hckwhr/fpga-instrument/docs/submission/figures/recording.pdf

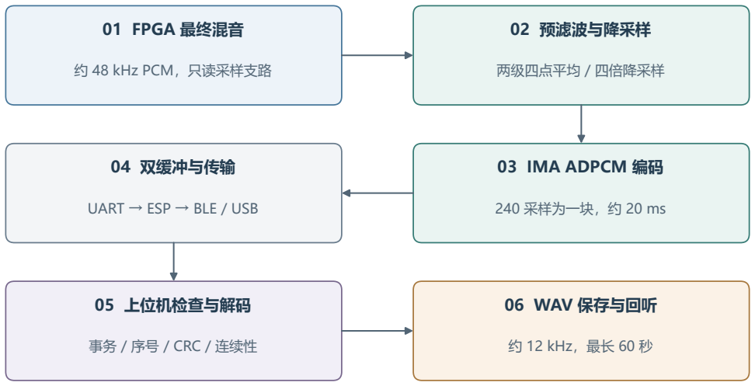
[picture p2: figure]
01 FPGA 最终混音; 约 48 kHz PCM，只读采样支路; 02 预滤波与降采样; 两级四点平均 / 四倍降采样; 03 IMA ADPCM 编码; 240 采样为一块，约 20 ms; 04 双缓冲与传输; UART → ESP → BLE / USB; 05 上位机检查与解码; 事务 / 序号 / CRC / 连续性; 06 WAV 保存与回听; 约 12 kHz，最长 60 秒

回传来自实际数字混音，不包含 DAC 与扬声器的模拟特性。
