hckwhr/fpga-instrument/docs/submission/figures/upload.pdf

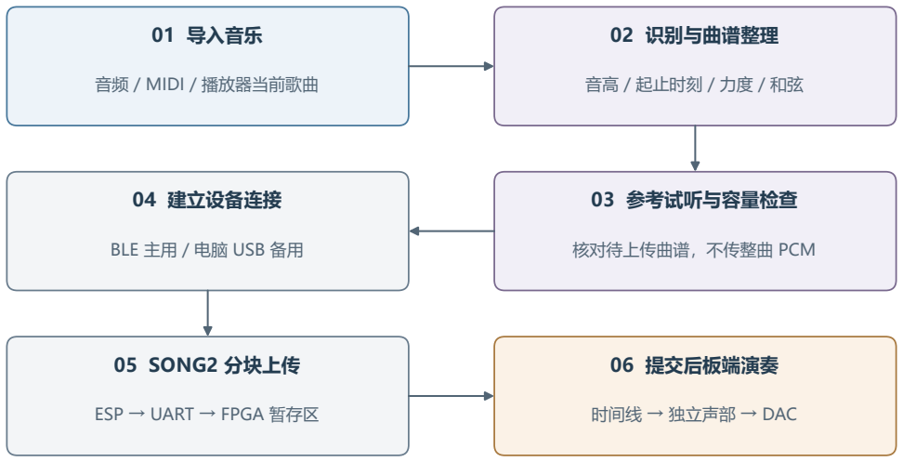
[picture p3: figure]
01 导入音乐; 音频 / MIDI / 播放器当前歌曲; 02 识别与曲谱整理; 音高 / 起止时刻 / 力度 / 和弦; 03 参考试听与容量检查; 核对待上传曲谱，不传整曲 PCM; 04 建立设备连接; BLE 主用 / 电脑 USB 备用; 05 SONG2 分块上传; ESP → UART → FPGA 暂存区; 06 提交后板端演奏; 时间线 → 独立声部 → DAC

COMMIT 发布完整曲谱；PLAY 才启动演奏时间线。
