hckwhr/fpga-instrument/docs/portfolio/README.md

# 灵弦：项目展示与求职材料

推荐项目名：**灵弦——基于 FPGA 的实时多音色合成与交互演奏系统**。

这个项目适合作为 FPGA / 数字 IC 前端 / 嵌入式系统岗位的主要项目。最值得讲清的是：独立声部如何调度、异步通信如何落到确定的板端动作、优化后如何证明功能和时序。上位机和 Android 应用体现系统完整度，投递 FPGA 岗位时不必占据简历的大部分篇幅。

| 材料 | 用法 |
| --- | --- |
| [简历条目](RESUME.md) | FPGA 岗位版、嵌入式岗位版、短版项目介绍 |
| [面试讲解](INTERVIEW.md) | 90 秒介绍、三个技术案例、追问与代码入口 |
| [演示与证据](EVIDENCE.md) | 三分钟展示顺序、数字来源与当前版本边界 |
| [仓库首页](../../README.md) | 发给招聘方的公开项目入口 |

GitHub：https://github.com/hckwhr/fpga-instrument

材料按 2026-11-11 归档状态整理。本次仅更新仓库展示和文档，不改变已验收 RTL、固件、应用逻辑或板上程序。

## 写进个人简历之前

材料描述的是项目已有成果。团队的硬件、软件和联调分工需要按本人实际参与情况填写；不要把整个团队、开源播放器或云端语音模型的工作写成个人独立开发。简历上保留自己能从接口、状态机、波形和测试讲清楚的内容；参与整合和验证也可以直接写“负责集成与验证”。

项目经历不依赖获奖标签。没有获得的奖项、名次和线下资格不写入；以源码、实物演奏、仿真与实施报告说明完成度。最新版本的 STA 通过与历史版本上板成功分别表述。
