hckwhr/fpga-instrument/hardware/V5/README.md

# V5 键盘板硬件工程

[键盘按键V5.epro2](键盘按键V5.epro2) 是当前 V5 键盘板的嘉立创 EDA 工程文件，由作者于 2026-11-01 提供。

使用嘉立创 EDA 专业版导入该文件，查看和编辑硬件设计。工程包含设计数据及内嵌图片资源，按原文件保存，不拆分内部数据。

对应 FPGA 源码入口为 [v3_hdmi_top.gprj](../../fpga/playability/v3_hdmi_top.gprj)，系统连接说明见 [HARDWARE.md](../../docs/HARDWARE.md)。
