hckwhr/fpga-instrument/fpga/rhythm/DECIMAL_CHANGE.md

# HDMI 单屏数字预计算

基线为 `v5_rhythm_hdmi_20261108`。该候选在 place3/route2 下报告 35 条未布通，
没有 `.pr`、时序报告或位流。原目录和失败报告保留。

失败日志没有网络名称，因此本次不能宣称十进制显示是那 35 条网络的已证实根因。
组合 BCD 中间实验未节省资源，未送 P&R。本候选改为帧前串行预计算：六字段共用
一个 BCD 加三单元。F 提交状态快照，F+1 读新状态，F+78 前完成全部字段转换。
生产 DMT 扫描在 60 行后显示画布，即 61440 拍，余量大于 787 倍。

- 数字在帧前预计算，RGB/HS/VS/DE 像素延迟不变，仍读取同一帧快照并输出相同字形。
- 保留短布局中 `position/100` 传入四位形参的截断行为，包括异常越界组合。
- 坐标除法、音频、32 声部、8 物理弦、菜单、RGB、UART、HDMI PHY 不改。
- 原 162 项全部保留；新增一项穷举，覆盖 4096 个值、全部长度及 999/1000 边界，
  并对优化前冻结渲染器进行 245760 次字形比较，总计 163 项。另检查 78 拍期限、
  提前使用必须发散的负向控制、中途换帧以及复位恢复。
- 先通过仿真和综合对照，再决定是否进入相同 place3/route2 的 P&R。
- 新网表重新生成共同 CE 约束并验证压缩等价，不沿用旧网表的端点名单。
- 本轮不烧录、不推送 GitHub。实测结果另记于 artifacts。
