hckwhr/fpga-instrument/fpga/rhythm/HDMI_ONLY_CHANGE.md

# HDMI 单屏恢复边界

- 基于已烧录双屏源码，独立目录开发，不覆盖双屏构建或板上程序。
- 生产顶层默认关闭双屏参数，去掉 LCD 物理端口。原 HDMI 菜单状态不再被屏蔽，
  原仪表盘负责设置与演奏两个页面。
- LCD PLL、LCD 时序、LCD 设置渲染与双屏专用演奏渲染不进入生产文件列表。
  相关源文件仅供历史模块回归，不删除旧功能验证证据。
- 删除 LCD 的 23 个物理输出约束及独立生成时钟，预期回到 31 I/O、4 时钟。
  端点压缩写法和共同 CE 连接图证明保持不变，新 SDC 必须来自新综合网表。
- 不修改音频引擎、PT8211 帧率、节奏事件、ADC/RGB 映射、串口协议或 HDMI PHY。
- 新增实体菜单刷新检查，原 161 项回归全部保留，总计 162 项；另运行三项官方 PHY。
- 用户所述显示迟滞尚未完成硬件根因归因，本候选不声称 LCD CDC 已被证明有误；
  按用户选择取消第二显示链路，并验证恢复后的 HDMI 页面每次按键都能更新。
- 本轮不自动烧录、不推送 GitHub。
