hckwhr/fpga-instrument/fpga/rhythm/DUAL_DISPLAY_CHANGE.md

# LCD 设置与 HDMI 演奏候选

目标板为 Tang Mega 138K，SOM30354 / Dock31005，GW5AST-138C，搭配 V5 压力键。
工程继承已烧录的 `v5_rhythm_timing_20261107`，保留其压力流水线、音频采样、
32 声部、8 路物理弦与串口协议。当前候选不能用基线的时序报告代替验收。

## 显示分工

- 原 800×480 RGB LCD：复用已验证的 33.333 MHz PLL、1057×526 总时序和
  23 个 LCD 引脚。独立的稳定总线握手传递设置快照，按 LCD 帧边界提交。
  设置快照不复用演奏快照中被曲目进度、按键状态占用的字段。
- HDMI：保留当前实物已支持的 800×600 DMT 输出及中心 800×480 画布。
  纯白背景，12 个固定键位，蓝色频谱、紫色李萨如，波形前景色保持原样。
  不显示参数文本，进入设置仍显示音频可视化。琴键按物理索引显示，
  跟练自定义音高不会改变左右位置。
- 两屏独立光栅和帧提交，不互相等待，不回压音频。新增 LCD 时钟及引脚
  需以本候选的实现报告验证；目标为 54 个物理 I/O、5 个时钟。

## 跟练所有权

普通 STOP 的历史语义保留。PERF1 操作 6 的启用命令先用共同 CE 交接
曲目/试听所有权，再在下一 CE 检查接收条件，后续 CE 快照并应答。
上位机仍先 STOP 再开始练习。CRC 无效、保留位非零和按键忙不触发交接；
菜单与本地操作优先级不被绕过。丢连接仍由原租约保护，不自动退回自由发声。

## 验证入口

`sync_test.ps1` 同步到独立 ASCII E 盘目录并运行专项；`-Full` 同步全部
候选输入并执行 161 项回归（原 159 项保留，新增双屏模块与双屏整机各 1 项）。
已有节奏整机用例增加内置曲、实际 SONG2 上传播放停止后切入跟练。
`verify_phy.ps1` 运行 3 项官方器件模型测试。

先综合，再对实际新网表运行 `prepare_constraints.ps1`，证明共同 CE、压缩
集合等价及负向控制，再用 place3/route2 实现。新增 LCD CDC 仅其音频侧可
进入 CE 证明，LCD 捕获侧保持全速；不按名字跳过证明。
通过建立/保持/恢复/移除检查、setup ≥ +0.03 ns、hold ≥ 0 和实际引脚审计后
才可作为烧录候选。当前任务不自动烧录，不推送 GitHub。

`TIMING_CHANGE.md` 是继承基线的压力流水线变更说明，不是本候选验收结果。
