hckwhr/fpga-instrument/fpga/rhythm/RHYTHM_PROTOCOL.md

# 实体 12 键跟练协议

目标：Tang Mega 138K，GW5AST-138C，SOM30354 / Dock31005 + V5 压力键。本双屏候选继承已验收 `v5_rhythm_timing_20261107`，保持原音频时钟、采样和既有音色，另恢复 LCD 的独立时钟与 23 个引脚。改动前证据为已烧录基线；本候选验收见 artifacts 对应报告，不能引用旧报告代替。

复用 PERF1 固定长度、CRC16-CCITT、8 位十六进制请求 ID、串口路由及 sys/audio 双向稳定总线握手。ESP 只转发完整文本行，不解析操作码。

请求 `PERF1,ID,OP,PAYLOAD,CRC\n`，41 字节；应答 `PERF1,ID,A,OP,STATUS,PAYLOAD,CRC\n`，45 字节。操作 0—5 保留原契约。6 写入提示或停止，7 查询并续租；7 请求负载必须为零。

操作 6 的 72 位负载：11:0 为左至右 12 键目标掩码；43:12 为 32 位提示编号；44 为启用；71:45 保留零。停止必须为全零。成功状态码 0，忙 2，无效 3。重复相同提示编号及掩码只续租、不清命中；相同编号不同掩码拒绝。主机一轮会话中递增编号，不重用旧编号作为新提示。

6/7 成功应答：71:70 标记 2，69 保护状态，68 活跃状态，67:36 提示编号，35:24 实体按键，23:12 本提示累计命中，11:0 剩余指引。主机同时验证请求 ID、操作码、CRC、提示编号与目标掩码；必须写入完成且应答到达才认定命令完成。失败应答不解释状态负载。

音频域在共同 CE 上接受命令。操作 6 的启用请求先核对保留位及按键占用状态：第一个 CE 交接曲目/试听所有权，第二个 CE 在更新后的阻塞条件下提交 gate，第三个 CE 将状态快照到原 result_map，随后返回 ACK。设置、本地停止和远程播放的优先级不被绕过；CRC 无效、保留位非零或按键忙不触发交接。其他节奏请求仍由 gate 更新后在下一 CE 快照。请求载荷保持到应答返回；结果快照保持到下次命令。没有新增异步多位直接采样。映射查询/修改与节奏命令串行，录音占有期间禁止节奏操作；节奏保护期间拒绝录音开始和键位修改。

实体新按下沿与目标掩码交集才加入播放键；旧按住键不能命中新提示。累计命中直到下一提示，因而按下和松开均早于轮询也不丢音。已接受的键保持到实体释放，不依赖 BLE 往返触发或关闭。原键盘事件 ID、32 声部与 8 路物理弦所有权逻辑不变。

租约 75,000,000 个 CE，生产约 3.05 秒。收到有效查询或提示续租。失联、设置、曲目抢占导致活跃清零，保留保护并清播放键，不能回退成无条件演奏；已有包络自然释放。明确停止解除保护，并抑制停止时仍按住的实体键直到释放。正常结束还恢复开始前的自定义映射或默认键阶；恢复失败必须上位机提示。

验证包含 gate 的 CE/租约/重奏/错按/和弦/停止，UART CRC、跨域请求应答、录音与映射互斥；整机串口及 ADC 引脚刺激、实际 C17 GRB 解码及 PT8211 PCM 解码，分别覆盖物理弦与 32 声部路径。本次补充内置曲目、实际 SONG2 上传播放停止后切入跟练，以及非法请求不交接所有权的检查。继承基线 159 项全部保留，新增双屏模块和双屏整机各 1 项，共 161 项；运行结果以本候选日志为准。
