hckwhr/fpga-instrument/host/instrument-web/RHYTHM_MODE.md

# 节奏大师（上位机练习模式）

FPGAvedio 有三个入口：播放器、FPGA 播放、节奏大师。桌面通过顶部按钮切换，手机通过左侧功能菜单切换。三个模式共用同一个曲谱工作台和连接会话，切换不会重新创建 BLE 连接。

## 使用

1. 打开节奏大师，选择《小星星》《欢乐颂》、FPGA 工作台当前曲谱或本地曲谱库。
2. 选择跟练或挑战，点击开始练习。两秒准备后，音符沿轨道落到判定线。
3. 电脑使用 `A S D F G H J K L ; ' Enter`；手机触摸音名对应的琴键。只在按对时合成声音，等待、漏按或错按不播放曲谱音频。
4. 跟练会在当前起音处等待，和弦的所有音都命中才继续。挑战保持时间推进，按起音偏差记录 Perfect（±70 ms）、Good（±160 ms）和 Miss。
5. 同一个键需松开后重新按下，长按及操作系统键盘连发不会重复计分。支持同时按多个键；部分电脑键盘存在硬件键位冲突，不能将其视为乐器压力键故障。
6. 暂停、切换模式、窗口失焦或进入后台会暂停练习并释放声音。返回后需主动继续，不自动恢复播放器音乐。

开始、暂停和重来在琴键画面上方。修改曲谱、速度或练习方式会重开本次练习。完成后显示命中数、最高连击、错按数和完成分。当前只对起音计分，长音提前松开会停止声音，不评价保持时长。

## 使用自己的曲谱

在 FPGA 播放中导入音频或 MIDI，完成转谱/音轨选择后，点击“用当前曲谱练习”。也可保存到曲谱库后在节奏大师中选择。曲谱库保存的是源音符，载入时只应用一次原有速度与力度设置，练习速度是其上的独立倍率。

固定 12 个键位，编号 01—12 对应左到右的位置，换曲不再重新排列。可选择 C 大调白键（C4、D4、E4、F4、G4、A4、B4、C5、D5、E5、F5、G5）或半音阶（C4—B4）。曲谱包含键阶之外的音高时明确拒绝；不自动删音、移调或折叠八度。同刻同音的多轨音符合并为一次按键，保留较长时值和较强力度，并显示合并数量。本机模式不改板端键位；实体模式临时配置所选键阶，停止且松开压力键后恢复原设置。

舞台使用近宽远窄的透视轨道，音符、长音尾迹和节拍线共用投影。宽屏左侧显示得分和连击，右侧保留曲谱与练习设置；手机竖屏的触键分成两排，以编号对应上方 12 条轨道。继续沿用播放器背景、字体及三模式切换。

## 硬件边界

“演奏设备”选择 **FPGA 实体 12 键 · RGB 跟练**。先在 FPGA 工作台连接 BLE 或 USB，退出板端设置并松开全部压力键，再开始。上位机先停止板端自动播放，读取原键位，再配置练习键阶。必须收到 FPGA 确认才进入跟练。旧位流不会被当作支持联动，需使用配套节奏协议位流。

到达当前音符时，RGB 以青色提示对应压力键。FPGA 在本地判断新按键是否属于本组目标，按对后直接进入原有声部/物理弦通路；按错不触发新音。力度和音色仍来自板端设置，声音不由电脑代播。和弦可以同时或依次按齐；同音下一次起音必须先松开。起音命中持续保存在本组状态，快速按下又松开也不会因蓝牙轮询漏掉。

实体模式只提供跟练，不把 BLE 收包时刻当作演奏时刻进行 Perfect/Good 评分。暂停、切换、失焦会发送停止；通信丢失时，板端约 3 秒租约到期后撤销提示与按键保持，阻止继续触发。已有音符按原包络释放，效果器尾音不会被硬切。恢复需要明确停止再开始，旧提示不会自动重播。停止后请松开压力键，让原键位恢复；无法确认恢复时界面会提示，不宣称已恢复。

这里演奏的是已转换的音符曲谱，不是直接把 MP3 音频流送到 FPGA。选择“FPGA 工作台当前曲谱”即可使用当前整理后的音乐；固定 12 键之外的音高仍需先在工作台明确处理。

## 维护与验证

- `src/rhythm-engine.js`：可独立测试的曲谱校验、时间推进、按键判定和计分。
- `src/rhythm-audio.js`：只由命中事件启动的本机合成音，松键/暂停释放。
- `src/rhythm-session.js`：实体会话、CRC 应答、提示序号、独占链路、轮询和停止恢复。
- `src/rhythm-view.js` / `src/rhythm.css`：共享桌面/手机界面、曲谱来源及生命周期。
- `npm run build`：语法检查、原有测试及新增节奏测试、离线资源构建。
- Mineradio 的 `tools/desktop-smoke.mjs`：实际打包应用中的模式切换、静音直到命中、松键重奏、原工作台回归。
- `tools/app-smoke.mjs --player`：手机尺寸浏览器中的菜单入口、触摸命中与原有转谱上传回归；其 BLE/板端应答是模拟数据，不代表手机或 FPGA 实物验收。

本机练习不依赖新位流。实体跟练需要更新 FPGA 和上位机；现有 ESP 完整行透明桥可转发新命令，不需要仅为这项功能重新烧录 ESP。Android 页面共用实现，APK 安装是单独的交付步骤。软件模拟接收端测试与 FPGA 引脚仿真均不代替实物联调。
