hckwhr/fpga-instrument/docs/submission/figures/design.pdf

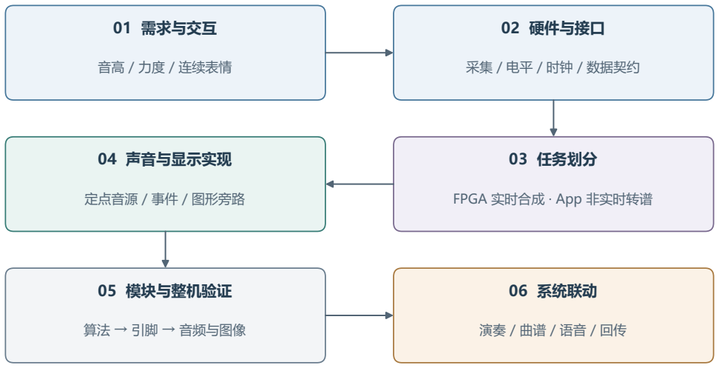
[picture p26: figure]
01 需求与交互; 音高 / 力度 / 连续表情; 02 硬件与接口; 采集 / 电平 / 时钟 / 数据契约; 03 任务划分; FPGA 实时合成 · App 非实时转谱; 04 声音与显示实现; 定点音源 / 事件 / 图形旁路; 05 模块与整机验证; 算法 → 引脚 → 音频与图像; 06 系统联动

先确定接口与采样期限，再核对完整输入输出链路。
