hckwhr/fpga-instrument/docs/submission/figures/display.pdf

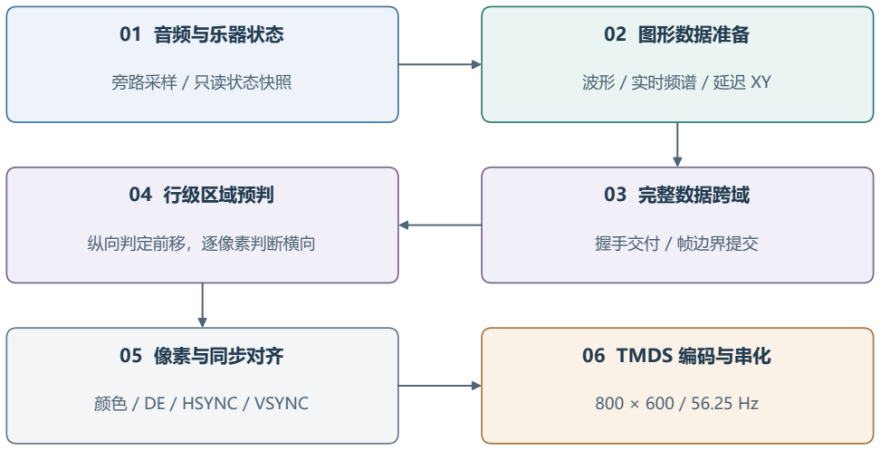
[picture p27: figure]
01 音频与乐器状态; 旁路采样 / 只读状态快照; 02 图形数据准备; 波形 / 实时频谱 / 延迟 XY; 03 完整数据跨域; 握手交付 / 帧边界提交; 04 行级区域预判; 纵向判定前移，逐像素判断横向; 05 像素与同步对齐; 颜色 / DE / HSYNC / VSYNC; 06 TMDS 编码与串化

显示和分析不反压音频；HDMI 仅输出图像。
