hckwhr/fpga-instrument/docs/submission/figures/events.pdf

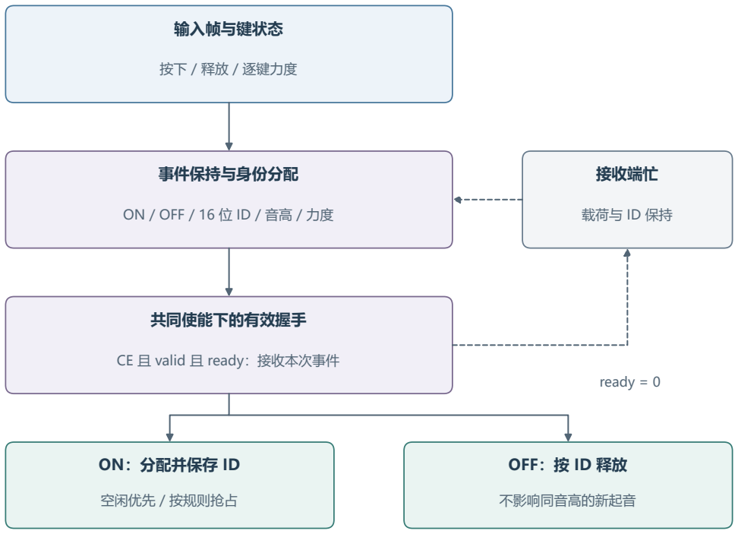
[picture p28: figure]
输入帧与键状态; 按下 / 释放 / 逐键力度; 事件保持与身份分配; ON / OFF / 16 位 ID / 音高 / 力度; 共同使能下的有效握手; CE 且 valid 且 ready：接收本次事件; 接收端忙; 载荷与 ID 保持; ON：分配并保存 ID; 空闲优先 / 按规则抢占; OFF：按 ID 释放; 不影响同音高的新起音; ready = 0
