hckwhr/fpga-instrument/docs/submission/figures/string.pdf

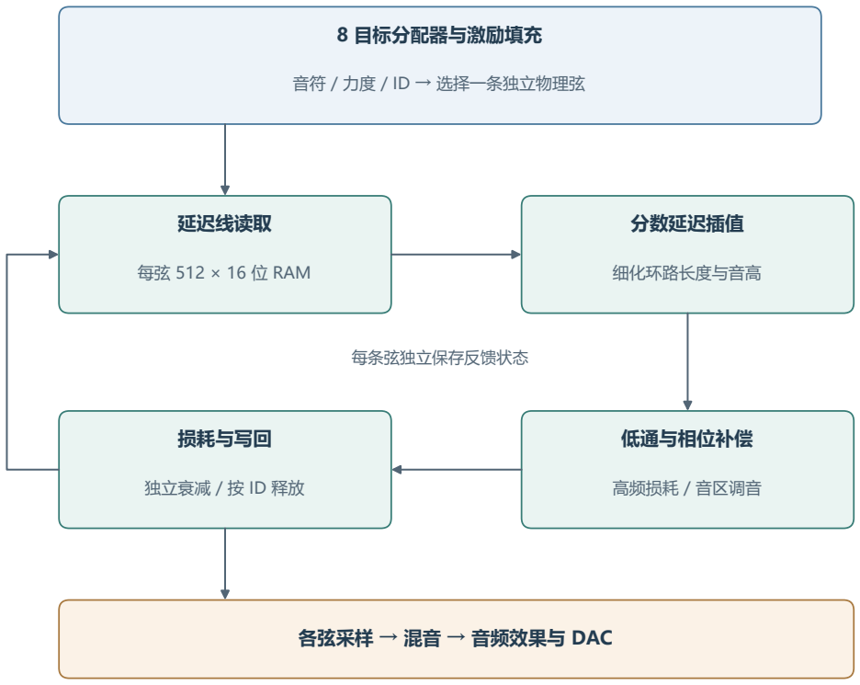
[picture p29: figure]
8 目标分配器与激励填充; 音符 / 力度 / ID → 选择一条独立物理弦; 延迟线读取; 每弦 512 × 16 位 RAM; 分数延迟插值; 细化环路长度与音高; 低通与相位补偿; 高频损耗 / 音区调音; 损耗与写回; 独立衰减 / 按 ID 释放; 每条弦独立保存反馈状态; 各弦采样 → 混音 → 音频效果与 DAC
