hckwhr/fpga-instrument/docs/submission/figures/voice.pdf

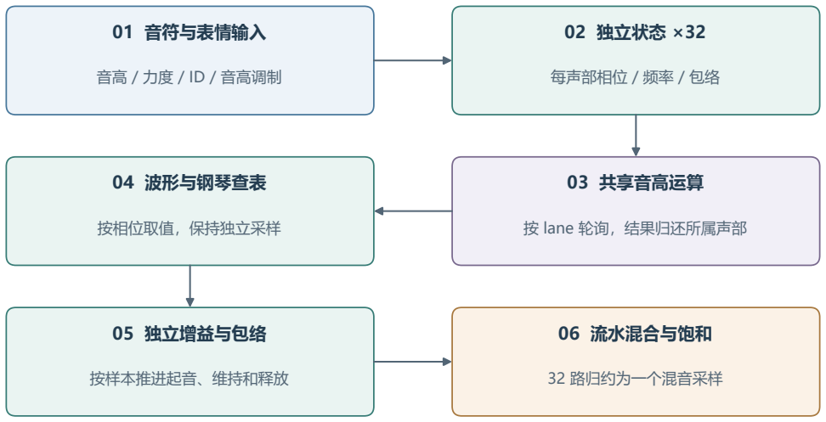
[picture p30: figure]
01 音符与表情输入; 音高 / 力度 / ID / 音高调制; 02 独立状态 ×32; 每声部相位 / 频率 / 包络; 03 共享音高运算; 按 lane 轮询，结果归还所属声部; 04 波形与钢琴查表; 按相位取值，保持独立采样; 05 独立增益与包络; 按样本推进起音、维持和释放; 06 流水混合与饱和; 32 路归约为一个混音采样

共享的是计算单元，32 份声部状态始终独立保存。
