hckwhr/fpga-instrument/docs/RHYTHM_MODE_VALIDATION.md

# 上位机节奏大师验证记录

日期：2026-11-05。

本次新增第三模式，保留播放器与 FPGA 工作台。FPGA RTL、ESP 固件和板端协议未修改。

| 验证 | 结果 |
| --- | --- |
| 共用上位机语法检查及构建 | 通过 |
| Node 单元测试 | 154 项通过，0 失败；原有 137 项，新增 17 项 |
| Windows 桌面包 | 构建通过 |
| Android 安装包 | 1.2.0（versionCode 106）构建通过，APK v2/v3 签名验证通过；未安装到手机 |
| 实际 Electron 桌面程序冒烟 | 通过；三模式往返、窗口控制、同一个工作台保持、未按静音、按对发声、重复键释放、暂停恢复、当前曲谱进入练习 |
| 原有工作台流程 | 通过；本地音频导入、真实模型转谱、整理、试听与可视化、模式切换后的曲谱保留 |
| 手机尺寸浏览器 | 390×844，侧栏进入、实际触摸事件命中、离开暂停、无横向溢出；通过 |
| 原手机上传与录音协议回归 | 通过；BLE/FPGA 应答使用明确标记的模拟端，不是实物验收 |

引擎测试覆盖：跟练等待、和弦、提前按下、按住不连击、松开重奏、Perfect/Good 实际毫秒窗口、漏按静音、暂停时间排除、重置、整曲结束、无效/超过 12 音高的曲谱拒绝、同刻同音合并及单调时钟要求。

运行中发现画面帧时间戳可能早于同帧输入时间戳，已统一采用 `performance.now()`；最终桌面与手机页面测试均通过。练习不发送自动播放或自定义硬件指令。

硬件限制：这一轮声音来自电脑/手机；实体 RGB 提示、压力键输入和 FPGA 本地判定仍需配套固件扩展。手机尺寸测试不等于已安装新版 APK。本轮未烧录 FPGA 或 ESP。

复现入口：`host/instrument-web` 中运行 `npm run build`；`host/mineradio` 中运行 `npm run prepare:fpga`、`npm run build:fpga:dir`、`node tools/desktop-smoke.mjs` 和 `node tools/app-smoke.mjs --player`。实际工具链路径见已有构建说明。
