hckwhr/fpga-instrument/fpga/rhythm/VALIDATION.md

# HDMI 单屏版本验收记录

2026-11-10：设置页和演奏页均恢复到底板 HDMI；LCD 不再参与生产工程。
完整回归、官方器件模型、P&R、时序及引脚/时钟审计通过，位流已生成，尚未烧录。
当前板上程序保持原样，未推送 GitHub。

## 行为与验证

- 实体设置键在 HDMI 打开设置页，退出后恢复原浅色仪表盘及演奏可视化。
- 保留音色切换、32 独立声部、8 路物理弦、12 压力键、RGB 与节奏跟练修复。
- 顶层去掉 23 个 LCD 物理输出及独立 LCD 时钟，生产文件列表不含 LCD 显示链。
  历史双屏源文件和用例保留，仅用于模块回归。
- 曲目进度、长度、速度、弦统计、力度、声部数共用帧前十进制预计算。
  帧后 78 拍完成，画布在 61440 拍后出现；像素/同步流水及画面内容不变。
  新增路径按正常像素时钟检查，没有增加时序放宽。

| 检查 | 证据 |
| --- | --- |
| 完整 RTL 回归 | 163 通过 / 0 失败；原 161 项保留，新增菜单刷新和数字预计算各 1 项 |
| 官方 HDMI 模型 | PLL 启动/频率、串化顺序、停钟复位 3 项通过 |
| 菜单引脚 | 十次单独按键音色切换，两帧内刷新，帧内不撕裂；退出后压力键到 DAC 解码通过 |
| 数字与帧边界 | 4096 个位置/长度及全部其他字段取值；245760 次冻结字形对照；63616 个曲目区像素对照 |
| 期限与异常控制 | 78 拍期限；提前使用负向用例确实发散；换帧中断、复位恢复、同拍状态更新通过 |
| 仪表盘等价 | 4608000 个缩放像素一致，含主界面与两页菜单及非恒定波形 |
| 演奏与跟练 | 实体 UART/ADC 激励到 RGB/PT8211 解码；错键静音、和弦、释放重按、歌曲 STOP 后切换跟练通过 |
| 共同使能 | 新网表 15992 个半速 FF、29 个模块；32 相位、32 包络和 8 路物理弦保留 |
| 约束压缩 | 捕获端查询 1800→633，20 个对象集合一致；6 项压缩控制和 4 项层级/使能控制通过 |
| 生效约束 | 4 个时钟、10 条 multicycle 命令；4 对共同 CE、1 对串化停钟复位 |
| 引脚 | 31 个物理 I/O 全覆盖，器件、差分配对、I/O 类型、电压、驱动和上下拉一致 |

## 实施结果

Gowin V1.9.12.03，GW5AST-LV138PG484AC1/I0，SOM30354 + Dock31005。
place3/route2 已从 `cmd.do` 核实，P&R 回执耗时 898.463 秒（约 15 分钟）。
工具正常结束、零错误，新的 `.pr`、完整 STA、引脚报告、`.fs` 均已生成。
成功日志没有单列未布通总数，不把缺失计数字段填成实测的 0。

| 指标 | 最终 P&R 报告 |
| --- | --- |
| Logic | 72539 / 138240（53%） |
| LUT / ALU / ROM16 | 57226 / 15313 / 0 |
| Register | 34810 / 139095（26%），锁存器 0 |
| CLS | 48587 / 69120（工具显示 71%） |
| BSRAM / DSP | 205 / 340；126 / 298 |
| SSRAM | 0 |
| Setup / hold | +0.556 ns / +0.187 ns |
| 建立 / 保持违例端点 | 0 / 0 |
| Recovery / Removal 最差余量 | +8.387 ns / +0.253 ns |
| Recovery / Removal 报告负余量 | 0 / 0，均有完整分析及最差路径表 |

满足 setup ≥ +0.03 ns、hold ≥ 0 的项目门槛。日志有一条 PR1014：`sys_clk_d`
使用通用布线资源；最终约束分析通过，但不把此警告解释为硬件实测结论。
本版 setup 小于先前已验收双屏版的 +2.010 ns，不能宣称时序余量提升。

源文件和实际构建输入哈希一致；SDC 的 20 个对象集合已对本次网表逐一证明等价。
Gowin HTML 对多行命令仅展示首行，完整端点与边沿语义需结合下列 SDC 哈希及
集合等价审计，不能只凭 HTML 首行声称证明全部端点。

位流 SHA256：`ff40e3adb2035a7261988d1a0774d62428b2bd41358e26e88484d48e5b972549`。
SDC SHA256：`d44577825f3f794bbaef5d3864755a66f3f14b100b58fafd3b7b8de960586e7f`。
综合网表 SHA256：`f426a74d1bb4dc01467afa8e192f2251a6f2825e786253d0fa48342be484a3aa`。

综合 ID：`d06cf2f74d314aa59fb8a9f8b40067bd`。
P&R ID：`f347393e8aa7430b9257dc4b44fc0fc3`。
本机证据：`artifacts/v5_rhythm_hdmi_digits_20261110/`，含原报告、位流、测试日志、
`result.json`、`input_hashes.json`、`applied_constraints.json`。
本机源目录：`work/v5_rhythm_hdmi_digits_20261110`。

此前 35 条未布通报告及没有资源收益的组合 BCD 实验均单独保留。
仿真证明在模型条件下每次菜单切换能更新；实际显示器和按键体验需烧录后观察，
本报告不将用户此前的 LCD 迟滞归因为已经证明的某个硬件故障。
