hckwhr/fpga-instrument/docs/submission/assets/performance.png

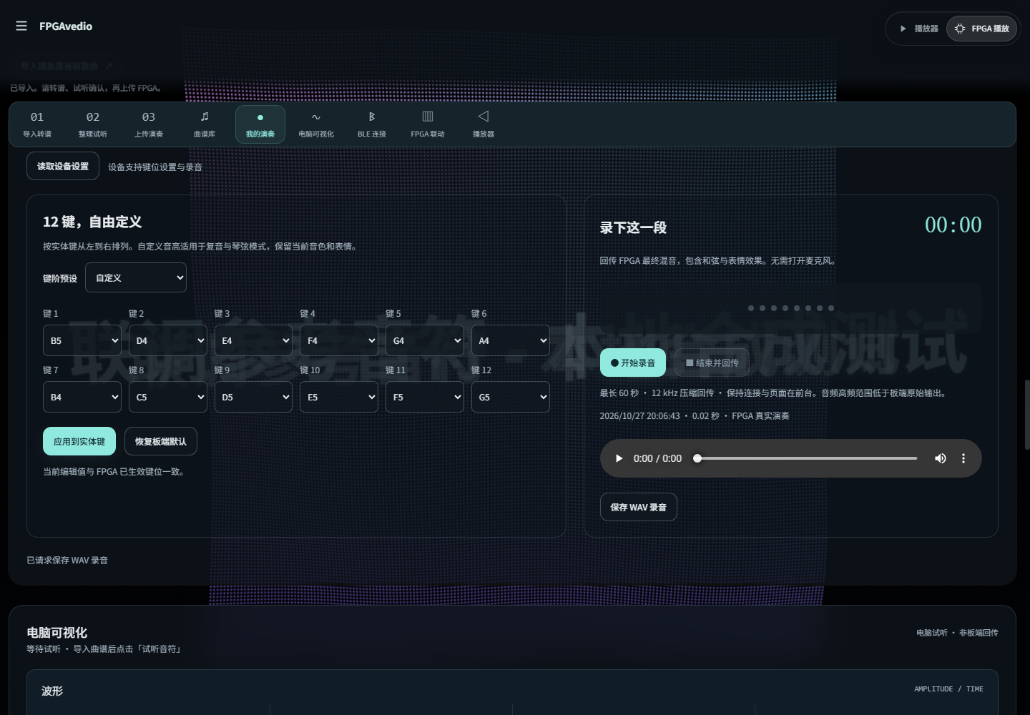
docs/submission/assets/performance.png
