hckwhr/fpga-instrument/docs/submission/figures/architecture.pdf

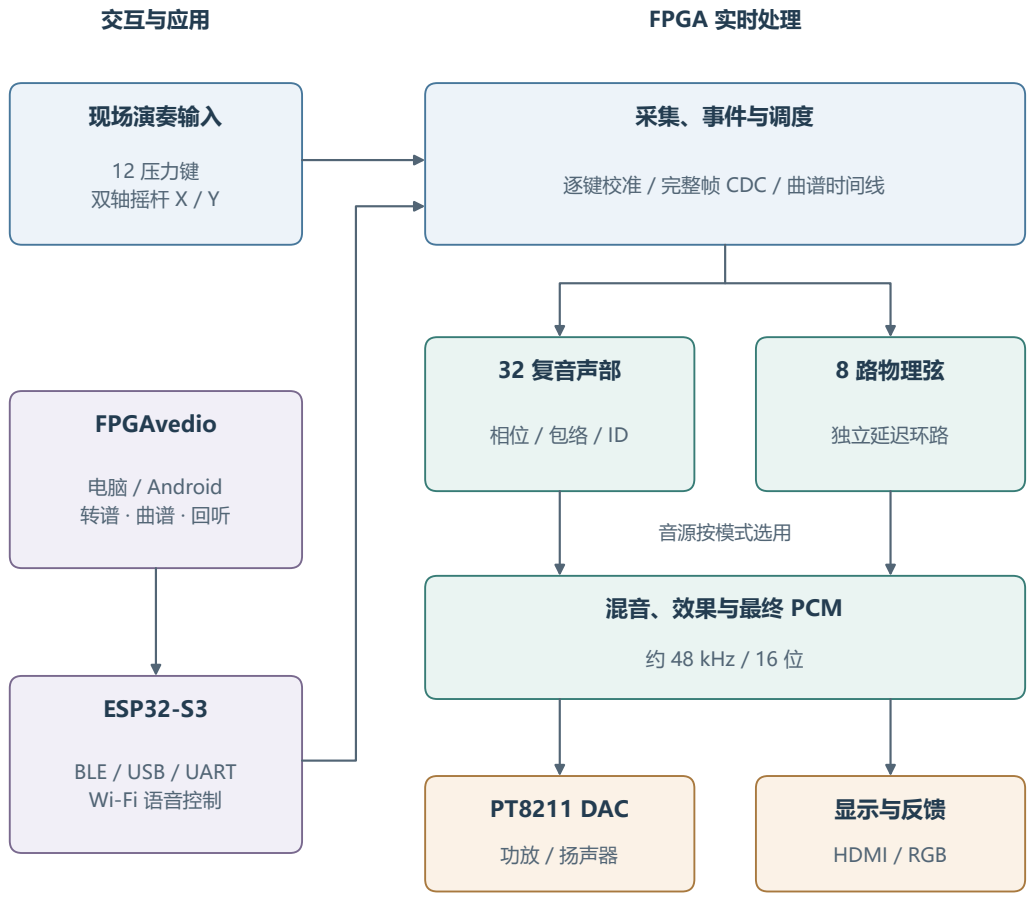
[picture p51: page 1]
交互与应用; FPGA 实时处理; 现场演奏输入; 12 压力键 双轴摇杆 X / Y; FPGAvedio; ESP32-S3; 采集、事件与调度; 32 复音声部; 8 路物理弦; 独立延迟环路; 约 48 kHz / 16 位; PT8211 DAC; 功放 / 扬声器; 显示与反馈; HDMI / RGB; 音源按模式选用

逐键校准 / 完整帧 CDC / 曲谱时间线

电脑 / Android

混音、效果与最终 PCM

BLE / USB / UART
Wi-Fi 语音控制
