hckwhr/fpga-instrument/firmware/xiaozhi-v3/main/boards/fpga-bread-s3/config.h

#pragma once
#include <driver/gpio.h>

// XiaoZhi v1.9.4 bread-compact-wifi SIMPLEX wiring, NOT the V3 PCB.
#define AUDIO_INPUT_SAMPLE_RATE 16000
#define AUDIO_OUTPUT_SAMPLE_RATE 24000
#define AUDIO_I2S_MIC_GPIO_WS GPIO_NUM_4
#define AUDIO_I2S_MIC_GPIO_SCK GPIO_NUM_5
#define AUDIO_I2S_MIC_GPIO_DIN GPIO_NUM_6
#define AUDIO_I2S_SPK_GPIO_DOUT GPIO_NUM_7
#define AUDIO_I2S_SPK_GPIO_BCLK GPIO_NUM_15
#define AUDIO_I2S_SPK_GPIO_LRCK GPIO_NUM_16
#define BOOT_BUTTON_GPIO GPIO_NUM_0
#define TOUCH_BUTTON_GPIO GPIO_NUM_47
#define VOLUME_UP_BUTTON_GPIO GPIO_NUM_40
#define VOLUME_DOWN_BUTTON_GPIO GPIO_NUM_39
#define BUILTIN_LED_GPIO GPIO_NUM_48
#define DISPLAY_SDA_PIN GPIO_NUM_41
#define DISPLAY_SCL_PIN GPIO_NUM_42
// GPIO17 TX -> FPGA A20; GPIO18 RX <- FPGA A21. No lamp on GPIO18.
// USB GPIO19/20, flash/PSRAM pins and the original audio pins are untouched.
