hckwhr/fpga-instrument/fpga/rhythm/rtl/fsr_instrument_top.v

`default_nettype none
// V2 board wrapper: the ADC owns A15; no UART or V3-header outputs are bonded.
module fsr_instrument_top (
    input wire sys_clk,key0_n,key1_n,key2_n,setting_key,adc_miso,
    output wire adc_sclk,adc_mosi,adc_cs0_n,adc_cs1_n,
    output wire [3:0] adc_led,
    output wire audio_bck,audio_ws,audio_din,audio_pa_en_n,
    output wire lcd_pclk,lcd_hsync,lcd_vsync,lcd_de,lcd_bl,
    output wire [5:0] lcd_r,lcd_g,lcd_b
);
    av_top #(.FSR_ENABLE(1)) u_instrument (
        .sys_clk(sys_clk),.key0_n(key0_n),.key1_n(key1_n),.key2_n(key2_n),.setting_key(setting_key),
        .hc05_rx(1'b1),.hc05_tx(),.status_led(),.ws2812_data(),.led_enable(),
        .adc_miso(adc_miso),.adc_sclk(adc_sclk),.adc_mosi(adc_mosi),
        .adc_cs0_n(adc_cs0_n),.adc_cs1_n(adc_cs1_n),.adc_led(adc_led),
        .audio_bck(audio_bck),.audio_ws(audio_ws),.audio_din(audio_din),.audio_pa_en_n(audio_pa_en_n),
        .lcd_pclk(lcd_pclk),.lcd_hsync(lcd_hsync),.lcd_vsync(lcd_vsync),.lcd_de(lcd_de),.lcd_bl(lcd_bl),
        .lcd_r(lcd_r),.lcd_g(lcd_g),.lcd_b(lcd_b));
endmodule
`default_nettype wire
