hckwhr/fpga-instrument/firmware/xiaozhi-v3/main/display/lcd_display.cc

#include "lcd_display.h"
#include "assets/lang_config.h"
#include "settings.h"

#include <vector>
#include <algorithm>
#include <font_awesome.h>
#include <esp_log.h>
#include <esp_err.h>
#include <esp_lvgl_port.h>
#include <esp_psram.h>
#include <cstring>

#include "board.h"

#define TAG "LcdDisplay"

// Color definitions for dark theme
#define DARK_BACKGROUND_COLOR       lv_color_hex(0x121212)     // Dark background
#define DARK_TEXT_COLOR             lv_color_white()           // White text
#define DARK_CHAT_BACKGROUND_COLOR  lv_color_hex(0x1E1E1E)     // Slightly lighter than background
#define DARK_USER_BUBBLE_COLOR      lv_color_hex(0x1A6C37)     // Dark green
#define DARK_ASSISTANT_BUBBLE_COLOR lv_color_hex(0x333333)     // Dark gray
#define DARK_SYSTEM_BUBBLE_COLOR    lv_color_hex(0x2A2A2A)     // Medium gray
#define DARK_SYSTEM_TEXT_COLOR      lv_color_hex(0xAAAAAA)     // Light gray text
#define DARK_BORDER_COLOR           lv_color_hex(0x333333)     // Dark gray border
#define DARK_LOW_BATTERY_COLOR      lv_color_hex(0xFF0000)     // Red for dark mode

// Color definitions for light theme
#define LIGHT_BACKGROUND_COLOR       lv_color_white()           // White background
#define LIGHT_TEXT_COLOR             lv_color_black()           // Black text
#define LIGHT_CHAT_BACKGROUND_COLOR  lv_color_hex(0xE0E0E0)     // Light gray background
#define LIGHT_USER_BUBBLE_COLOR      lv_color_hex(0x95EC69)     // WeChat green
#define LIGHT_ASSISTANT_BUBBLE_COLOR lv_color_white()           // White
#define LIGHT_SYSTEM_BUBBLE_COLOR    lv_color_hex(0xE0E0E0)     // Light gray
#define LIGHT_SYSTEM_TEXT_COLOR      lv_color_hex(0x666666)     // Dark gray text
#define LIGHT_BORDER_COLOR           lv_color_hex(0xE0E0E0)     // Light gray border
#define LIGHT_LOW_BATTERY_COLOR      lv_color_black()           // Black for light mode


// Define dark theme colors
const ThemeColors DARK_THEME = {
    .background = DARK_BACKGROUND_COLOR,
    .text = DARK_TEXT_COLOR,
    .chat_background = DARK_CHAT_BACKGROUND_COLOR,
    .user_bubble = DARK_USER_BUBBLE_COLOR,
    .assistant_bubble = DARK_ASSISTANT_BUBBLE_COLOR,
    .system_bubble = DARK_SYSTEM_BUBBLE_COLOR,
    .system_text = DARK_SYSTEM_TEXT_COLOR,
    .border = DARK_BORDER_COLOR,
    .low_battery = DARK_LOW_BATTERY_COLOR
};

// Define light theme colors
const ThemeColors LIGHT_THEME = {
    .background = LIGHT_BACKGROUND_COLOR,
    .text = LIGHT_TEXT_COLOR,
    .chat_background = LIGHT_CHAT_BACKGROUND_COLOR,
    .user_bubble = LIGHT_USER_BUBBLE_COLOR,
    .assistant_bubble = LIGHT_ASSISTANT_BUBBLE_COLOR,
    .system_bubble = LIGHT_SYSTEM_BUBBLE_COLOR,
    .system_text = LIGHT_SYSTEM_TEXT_COLOR,
    .border = LIGHT_BORDER_COLOR,
    .low_battery = LIGHT_LOW_BATTERY_COLOR
};


LV_FONT_DECLARE(font_awesome_30_4);

LcdDisplay::LcdDisplay(esp_lcd_panel_io_handle_t panel_io, esp_lcd_panel_handle_t panel, DisplayFonts fonts, int width, int height)
    : panel_io_(panel_io), panel_(panel), fonts_(fonts) {
    width_ = width;
    height_ = height;

    // Load theme from settings
    Settings settings("display", false);
    current_theme_name_ = settings.GetString("theme", "light");

    // Update the theme
    if (current_theme_name_ == "dark") {
        current_theme_ = DARK_THEME;
    } else if (current_theme_name_ == "light") {
        current_theme_ = LIGHT_THEME;
    }
}

SpiLcdDisplay::SpiLcdDisplay(esp_lcd_panel_io_handle_t panel_io, esp_lcd_panel_handle_t panel,
                           int width, int height, int offset_x, int offset_y, bool mirror_x, bool mirror_y, bool swap_xy,
                           DisplayFonts fonts)
    : LcdDisplay(panel_io, panel, fonts, width, height) {

    // draw white
    std::vector<uint16_t> buffer(width_, 0xFFFF);
    for (int y = 0; y < height_; y++) {
        esp_lcd_panel_draw_bitmap(panel_, 0, y, width_, y + 1, buffer.data());
    }

    // Set the display to on
    ESP_LOGI(TAG, "Turning display on");
    ESP_ERROR_CHECK(esp_lcd_panel_disp_on_off(panel_, true));

    ESP_LOGI(TAG, "Initialize LVGL library");
    lv_init();

#if CONFIG_SPIRAM
    // lv image cache, currently only PNG is supported
    size_t psram_size_mb = esp_psram_get_size() / 1024 / 1024;
    if (psram_size_mb >= 8) {
        lv_image_cache_resize(2 * 1024 * 1024, true);
        ESP_LOGI(TAG, "Use 2MB of PSRAM for image cache");
    } else if (psram_size_mb >= 2) {
        lv_image_cache_resize(512 * 1024, true);
        ESP_LOGI(TAG, "Use 512KB of PSRAM for image cache");
    }
#endif

    ESP_LOGI(TAG, "Initialize LVGL port");
    lvgl_port_cfg_t port_cfg = ESP_LVGL_PORT_INIT_CONFIG();
    port_cfg.task_priority = 1;
#if CONFIG_SOC_CPU_CORES_NUM > 1
    port_cfg.task_affinity = 1;
#endif
    lvgl_port_init(&port_cfg);

    ESP_LOGI(TAG, "Adding LCD display");
    const lvgl_port_display_cfg_t display_cfg = {
        .io_handle = panel_io_,
        .panel_handle = panel_,
        .control_handle = nullptr,
        .buffer_size = static_cast<uint32_t>(width_ * 20),
        .double_buffer = false,
        .trans_size = 0,
        .hres = static_cast<uint32_t>(width_),
        .vres = static_cast<uint32_t>(height_),
        .monochrome = false,
        .rotation = {
            .swap_xy = swap_xy,
            .mirror_x = mirror_x,
            .mirror_y = mirror_y,
        },
        .color_format = LV_COLOR_FORMAT_RGB565,
        .flags = {
            .buff_dma = 1,
            .buff_spiram = 0,
            .sw_rotate = 0,
            .swap_bytes = 1,
            .full_refresh = 0,
            .direct_mode = 0,
        },
    };

    display_ = lvgl_port_add_disp(&display_cfg);
    if (display_ == nullptr) {
        ESP_LOGE(TAG, "Failed to add display");
        return;
    }

    if (offset_x != 0 || offset_y != 0) {
        lv_display_set_offset(display_, offset_x, offset_y);
    }

    SetupUI();
}

// RGB LCD实现
RgbLcdDisplay::RgbLcdDisplay(esp_lcd_panel_io_handle_t panel_io, esp_lcd_panel_handle_t panel,
                           int width, int height, int offset_x, int offset_y,
                           bool mirror_x, bool mirror_y, bool swap_xy,
                           DisplayFonts fonts)
    : LcdDisplay(panel_io, panel, fonts, width, height) {

    // draw white
    std::vector<uint16_t> buffer(width_, 0xFFFF);
    for (int y = 0; y < height_; y++) {
        esp_lcd_panel_draw_bitmap(panel_, 0, y, width_, y + 1, buffer.data());
    }

    ESP_LOGI(TAG, "Initialize LVGL library");
    lv_init();

    ESP_LOGI(TAG, "Initialize LVGL port");
    lvgl_port_cfg_t port_cfg = ESP_LVGL_PORT_INIT_CONFIG();
    port_cfg.task_priority = 1;
#if CONFIG_SOC_CPU_CORES_NUM > 1
    port_cfg.task_affinity = 1;
#endif
    lvgl_port_init(&port_cfg);

    ESP_LOGI(TAG, "Adding LCD display");
    const lvgl_port_display_cfg_t display_cfg = {
        .io_handle = panel_io_,
        .panel_handle = panel_,
        .buffer_size = static_cast<uint32_t>(width_ * 20),
        .double_buffer = true,
        .hres = static_cast<uint32_t>(width_),
        .vres = static_cast<uint32_t>(height_),
        .rotation = {
            .swap_xy = swap_xy,
            .mirror_x = mirror_x,
            .mirror_y = mirror_y,
        },
        .flags = {
            .buff_dma = 1,
            .swap_bytes = 0,
            .full_refresh = 1,
            .direct_mode = 1,
        },
    };

    const lvgl_port_display_rgb_cfg_t rgb_cfg = {
        .flags = {
            .bb_mode = true,
            .avoid_tearing = true,
        }
    };
    
    display_ = lvgl_port_add_disp_rgb(&display_cfg, &rgb_cfg);
    if (display_ == nullptr) {
        ESP_LOGE(TAG, "Failed to add RGB display");
        return;
    }
    
    if (offset_x != 0 || offset_y != 0) {
        lv_display_set_offset(display_, offset_x, offset_y);
    }

    SetupUI();
}

MipiLcdDisplay::MipiLcdDisplay(esp_lcd_panel_io_handle_t panel_io, esp_lcd_panel_handle_t panel,
                            int width, int height,  int offset_x, int offset_y,
                            bool mirror_x, bool mirror_y, bool swap_xy,
                            DisplayFonts fonts)
    : LcdDisplay(panel_io, panel, fonts, width, height) {

    // Set the display to on
    ESP_LOGI(TAG, "Turning display on");
    ESP_ERROR_CHECK(esp_lcd_panel_disp_on_off(panel_, true));

    ESP_LOGI(TAG, "Initialize LVGL library");
    lv_init();

    ESP_LOGI(TAG, "Initialize LVGL port");
    lvgl_port_cfg_t port_cfg = ESP_LVGL_PORT_INIT_CONFIG();
    port_cfg.task_priority = 1;
#if CONFIG_SOC_CPU_CORES_NUM > 1
    port_cfg.task_affinity = 1;
#endif
    lvgl_port_init(&port_cfg);

    ESP_LOGI(TAG, "Adding LCD display");
    const lvgl_port_display_cfg_t disp_cfg = {
            .io_handle = panel_io,
            .panel_handle = panel,
            .control_handle = nullptr,
            .buffer_size = static_cast<uint32_t>(width_ * 50),
            .double_buffer = false,
            .hres = static_cast<uint32_t>(width_),
            .vres = static_cast<uint32_t>(height_),
            .monochrome = false,
            /* Rotation values must be same as used in esp_lcd for initial settings of the screen */
            .rotation = {
            .swap_xy = swap_xy,
            .mirror_x = mirror_x,
            .mirror_y = mirror_y,
        },
        .flags = {
            .buff_dma = true,
            .buff_spiram =false,
            .sw_rotate = false,
        },
    };

    const lvgl_port_display_dsi_cfg_t dpi_cfg = {
        .flags = {
            .avoid_tearing = false,
        }
    };
    display_ = lvgl_port_add_disp_dsi(&disp_cfg, &dpi_cfg);
    if (display_ == nullptr) {
        ESP_LOGE(TAG, "Failed to add display");
        return;
    }

    if (offset_x != 0 || offset_y != 0) {
        lv_display_set_offset(display_, offset_x, offset_y);
    }

    SetupUI();
}

LcdDisplay::~LcdDisplay() {
    // 然后再清理 LVGL 对象
    if (content_ != nullptr) {
        lv_obj_del(content_);
    }
    if (status_bar_ != nullptr) {
        lv_obj_del(status_bar_);
    }
    if (side_bar_ != nullptr) {
        lv_obj_del(side_bar_);
    }
    if (container_ != nullptr) {
        lv_obj_del(container_);
    }
    if (display_ != nullptr) {
        lv_display_delete(display_);
    }

    if (panel_ != nullptr) {
        esp_lcd_panel_del(panel_);
    }
    if (panel_io_ != nullptr) {
        esp_lcd_panel_io_del(panel_io_);
    }
}

bool LcdDisplay::Lock(int timeout_ms) {
    return lvgl_port_lock(timeout_ms);
}

void LcdDisplay::Unlock() {
    lvgl_port_unlock();
}

#if CONFIG_USE_WECHAT_MESSAGE_STYLE
void LcdDisplay::SetupUI() {
    DisplayLockGuard lock(this);

    auto screen = lv_screen_active();
    lv_obj_set_style_text_font(screen, fonts_.text_font, 0);
    lv_obj_set_style_text_color(screen, current_theme_.text, 0);
    lv_obj_set_style_bg_color(screen, current_theme_.background, 0);

    /* Container */
    container_ = lv_obj_create(screen);
    lv_obj_set_size(container_, LV_HOR_RES, LV_VER_RES);
    lv_obj_set_flex_flow(container_, LV_FLEX_FLOW_COLUMN);
    lv_obj_set_style_pad_all(container_, 0, 0);
    lv_obj_set_style_border_width(container_, 0, 0);
    lv_obj_set_style_pad_row(container_, 0, 0);
    lv_obj_set_style_bg_color(container_, current_theme_.background, 0);
    lv_obj_set_style_border_color(container_, current_theme_.border, 0);

    /* Status bar */
    status_bar_ = lv_obj_create(container_);
    lv_obj_set_size(status_bar_, LV_HOR_RES, LV_SIZE_CONTENT);
    lv_obj_set_style_radius(status_bar_, 0, 0);
    lv_obj_set_style_bg_color(status_bar_, current_theme_.background, 0);
    lv_obj_set_style_text_color(status_bar_, current_theme_.text, 0);
    
    /* Content - Chat area */
    content_ = lv_obj_create(container_);
    lv_obj_set_style_radius(content_, 0, 0);
    lv_obj_set_width(content_, LV_HOR_RES);
    lv_obj_set_flex_grow(content_, 1);
    lv_obj_set_style_pad_all(content_, 10, 0);
    lv_obj_set_style_bg_color(content_, current_theme_.chat_background, 0); // Background for chat area
    lv_obj_set_style_border_color(content_, current_theme_.border, 0); // Border color for chat area

    // Enable scrolling for chat content
    lv_obj_set_scrollbar_mode(content_, LV_SCROLLBAR_MODE_OFF);
    lv_obj_set_scroll_dir(content_, LV_DIR_VER);
    
    // Create a flex container for chat messages
    lv_obj_set_flex_flow(content_, LV_FLEX_FLOW_COLUMN);
    lv_obj_set_flex_align(content_, LV_FLEX_ALIGN_START, LV_FLEX_ALIGN_START, LV_FLEX_ALIGN_START);
    lv_obj_set_style_pad_row(content_, 10, 0); // Space between messages

    // We'll create chat messages dynamically in SetChatMessage
    chat_message_label_ = nullptr;

    /* Status bar */
    lv_obj_set_flex_flow(status_bar_, LV_FLEX_FLOW_ROW);
    lv_obj_set_style_pad_all(status_bar_, 0, 0);
    lv_obj_set_style_border_width(status_bar_, 0, 0);
    lv_obj_set_style_pad_column(status_bar_, 0, 0);
    lv_obj_set_style_pad_left(status_bar_, 10, 0);
    lv_obj_set_style_pad_right(status_bar_, 10, 0);
    lv_obj_set_style_pad_top(status_bar_, 2, 0);
    lv_obj_set_style_pad_bottom(status_bar_, 2, 0);
    lv_obj_set_scrollbar_mode(status_bar_, LV_SCROLLBAR_MODE_OFF);
    // 设置状态栏的内容垂直居中
    lv_obj_set_flex_align(status_bar_, LV_FLEX_ALIGN_SPACE_BETWEEN, LV_FLEX_ALIGN_CENTER, LV_FLEX_ALIGN_CENTER);

    // 创建emotion_label_在状态栏最左侧
    emotion_label_ = lv_label_create(status_bar_);
    lv_obj_set_style_text_font(emotion_label_, &font_awesome_30_4, 0);
    lv_obj_set_style_text_color(emotion_label_, current_theme_.text, 0);
    lv_label_set_text(emotion_label_, FONT_AWESOME_MICROCHIP_AI);
    lv_obj_set_style_margin_right(emotion_label_, 5, 0); // 添加右边距，与后面的元素分隔

    notification_label_ = lv_label_create(status_bar_);
    lv_obj_set_flex_grow(notification_label_, 1);
    lv_obj_set_style_text_align(notification_label_, LV_TEXT_ALIGN_CENTER, 0);
    lv_obj_set_style_text_color(notification_label_, current_theme_.text, 0);
    lv_label_set_text(notification_label_, "");
    lv_obj_add_flag(notification_label_, LV_OBJ_FLAG_HIDDEN);

    status_label_ = lv_label_create(status_bar_);
    lv_obj_set_flex_grow(status_label_, 1);
    lv_label_set_long_mode(status_label_, LV_LABEL_LONG_SCROLL_CIRCULAR);
    lv_obj_set_style_text_align(status_label_, LV_TEXT_ALIGN_CENTER, 0);
    lv_obj_set_style_text_color(status_label_, current_theme_.text, 0);
    lv_label_set_text(status_label_, Lang::Strings::INITIALIZING);
    
    mute_label_ = lv_label_create(status_bar_);
    lv_label_set_text(mute_label_, "");
    lv_obj_set_style_text_font(mute_label_, fonts_.icon_font, 0);
    lv_obj_set_style_text_color(mute_label_, current_theme_.text, 0);

    network_label_ = lv_label_create(status_bar_);
    lv_label_set_text(network_label_, "");
    lv_obj_set_style_text_font(network_label_, fonts_.icon_font, 0);
    lv_obj_set_style_text_color(network_label_, current_theme_.text, 0);
    lv_obj_set_style_margin_left(network_label_, 5, 0); // 添加左边距，与前面的元素分隔

    battery_label_ = lv_label_create(status_bar_);
    lv_label_set_text(battery_label_, "");
    lv_obj_set_style_text_font(battery_label_, fonts_.icon_font, 0);
    lv_obj_set_style_text_color(battery_label_, current_theme_.text, 0);
    lv_obj_set_style_margin_left(battery_label_, 5, 0); // 添加左边距，与前面的元素分隔

    low_battery_popup_ = lv_obj_create(screen);
    lv_obj_set_scrollbar_mode(low_battery_popup_, LV_SCROLLBAR_MODE_OFF);
    lv_obj_set_size(low_battery_popup_, LV_HOR_RES * 0.9, fonts_.text_font->line_height * 2);
    lv_obj_align(low_battery_popup_, LV_ALIGN_BOTTOM_MID, 0, 0);
    lv_obj_set_style_bg_color(low_battery_popup_, current_theme_.low_battery, 0);
    lv_obj_set_style_radius(low_battery_popup_, 10, 0);
    low_battery_label_ = lv_label_create(low_battery_popup_);
    lv_label_set_text(low_battery_label_, Lang::Strings::BATTERY_NEED_CHARGE);
    lv_obj_set_style_text_color(low_battery_label_, lv_color_white(), 0);
    lv_obj_center(low_battery_label_);
    lv_obj_add_flag(low_battery_popup_, LV_OBJ_FLAG_HIDDEN);
}
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
