hckwhr/fpga-instrument/firmware/xiaozhi-v3/main/display/oled_display.cc

#include "oled_display.h"
#include "assets/lang_config.h"

#include <string>
#include <algorithm>

#include <esp_log.h>
#include <esp_err.h>
#include <esp_lvgl_port.h>
#include <font_awesome.h>

#define TAG "OledDisplay"

LV_FONT_DECLARE(font_awesome_30_1);

OledDisplay::OledDisplay(esp_lcd_panel_io_handle_t panel_io, esp_lcd_panel_handle_t panel,
    int width, int height, bool mirror_x, bool mirror_y, DisplayFonts fonts, bool synchronous_i2c)
    : panel_io_(panel_io), panel_(panel), fonts_(fonts) {
    width_ = width;
    height_ = height;

    ESP_LOGI(TAG, "Initialize LVGL");
    lvgl_port_cfg_t port_cfg = ESP_LVGL_PORT_INIT_CONFIG();
    port_cfg.task_priority = 1;
    port_cfg.task_stack = 6144;
#if CONFIG_SOC_CPU_CORES_NUM > 1
    port_cfg.task_affinity = 1;
#endif
    ESP_ERROR_CHECK(lvgl_port_init(&port_cfg));

    ESP_LOGI(TAG, "Adding OLED display");
    const lvgl_port_display_cfg_t display_cfg = {
        .io_handle = panel_io_,
        .panel_handle = panel_,
        .control_handle = nullptr,
        .buffer_size = static_cast<uint32_t>(width_ * height_),
        .double_buffer = false,
        .trans_size = 0,
        .hres = static_cast<uint32_t>(width_),
        .vres = static_cast<uint32_t>(height_),
        .monochrome = true,
        .rotation = {
            .swap_xy = false,
            .mirror_x = mirror_x,
            .mirror_y = mirror_y,
        },
        .flags = {
            .buff_dma = 1,
            .buff_spiram = 0,
            .sw_rotate = 0,
            .full_refresh = 0,
            .direct_mode = 0,
        },
    };

    // Hold the port mutex from display registration through UI construction,
    // so its first refresh cannot race installation of the I2C wait fallback.
    DisplayLockGuard lock(this);
    if (!lock) {
        return;
    }
    display_ = lvgl_port_add_disp(&display_cfg);
    if (display_ == nullptr) {
        ESP_LOGE(TAG, "Failed to add display");
        return;
    }

    if (synchronous_i2c) {
        // IDF's I2C panel IO completes transmission before draw_bitmap returns.
        // On NACK it returns an error without the port's flush-ready callback;
        // otherwise LVGL spins forever while holding its mutex. This fallback
        // must NOT be used with asynchronous SPI/DMA display transports.
        lv_display_set_flush_wait_cb(display_, [](lv_display_t* display) {
            ESP_LOGW(TAG, "OLED I2C flush returned without completion; dropping frame");
            lv_display_flush_ready(display);
        });
    }

    if (height_ == 64) {
        SetupUI_128x64();
    } else {
        SetupUI_128x32();
    }
}
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
