hckwhr/fpga-instrument/(commit log)

2026-10-24 feat(repo): consolidate FPGA instrument, desktop app and ESP32 firmware
    [16m.csv, 16m_c3.csv, 16m_custom_wakeword.csv, 16m_echoear.csv, 32m.csv, 4m.csv, 4m_esp-hi.csv, 8m.csv]
2026-10-24 feat(playback): align instrumental preparation and FPGA articulation
    Simplify instrumental preparation and add a stage65 FPGA reference preview. Preserve manual sound while applying score decay and dry playback. Archive the accepted stage65 source, bitstream and reports without replacing stage64.
    Validation: 108 host tests and 138 RTL cases pass; setup +0.043 ns, hold +0.185 ns, zero violations, 45 pins and 3 clocks audited. Stage65 has not been flashed or evaluated on physical audio hardware.
2026-10-24 docs(fpga): record verified stage65 flash programming
2026-10-24 feat(link): keep BLE primary and add manual USB backup
    Add session-isolated USB transport, explicit desktop port grants and shared bridge ownership. Keep UART at 115200 and FPGA stage65 unchanged. Record software tests and an unflashed ESP32-S3 candidate; hardware throughput and recovery remain unverified.
2026-10-26 feat(fpga): archive programmed stage68 HDMI build and current UI
    Preserve stage65 LCD baseline and add byte-identical stage68 inputs, bitstream, implementation netlist, timing and programming evidence. Document hardware validation boundaries and refresh current build navigation. Sync the BLE/USB selector styling.
2026-10-27 feat(performance): add custom key mapping and FPGA audio recording
    Share 12-key editing and verified PCM recording/export across desktop and Android. Preserve the programmed baseline and archive an independent FPGA build with passing timing and pin audits. Retain 143 regressions and add four contract cases; hardware recording remains to be exercised after flashing.
2026-11-01 feat(hardware): add current V5 EasyEDA keyboard project
2026-11-05 fix(host): stabilize recording controls and refresh twelve-key rhythm stage
2026-11-07 feat(host): connect rhythm practice to FPGA pressure keys and RGB cues
    Require matching PERF1 acknowledgements, preserve sticky cue hits, and restore key maps on stop. Validate with 162 Node tests, browser/desktop smoke tests, and 360 production bridge roundtrips. Requires companion rhythm FPGA image; board behavior not yet observed.
2026-11-07 perf(fpga): pipeline pressure conversion for rhythm timing margin
    Preserve the validated rhythm candidate as an isolated source snapshot. Split pressure arithmetic while keeping coherent frames and the exact velocity curve; add 80 ns at 50 MHz. Verify 159 regressions, 3 vendor-model tests, routed setup +2.596 ns / hold +0.195 ns, and pin/clock audits. Hardware programming remains pending.
2026-11-08 fix(host): unblock rhythm startup and add adaptive twelve-key stage
2026-11-08 feat(fpga): split LCD settings and HDMI performance views
    Fix rhythm ownership handoff after score playback and keep twelve physical key lanes aligned. Validate 161 RTL tests, three official HDMI model tests, common-CE constraints, 54 pins and five clocks. P&R passes with setup +2.010 ns and hold +0.185 ns; hardware is not programmed.
    [av_hdmi_top.v, instrument_control.v, instrument_panel_renderer.v, instrument_production_link.v, lcd_settings_display.v, performance_stage_renderer.v, performance_uart.v, tb_dual_display.sv]
2026-11-10 fix(fpga): restore HDMI-only menus with frame-precomputed digits
    [av_hdmi_top.v, baseline_decimal_panel.v, instrument_panel_renderer.v, tb_hdmi_instrument_pins.sv, tb_panel_decimal_exact.sv, v3_hdmi_top.v]
